GroundStudio/Jade_U1/README.md

GroundStudio Jade U1
====================================
JadeU1

Get it from [ardushop.ro](https://ardushop.ro/ro/118-groundstudio)

Explore all the GroundStudio products at [GroundStudio.ro](https://groundstudio.ro/)

Description
-------------------
ATMEGA328P based development board, 32kBytes of In-System Self-Programmable Flash program memory,  1kBytes EEPROM, 2kBytes Internal SRAM, 6 PWM Pins, 20 Digital Pins including 6 ADC with 10 bit Resolution and HT42B534-2 chip for USB comunication.

Contents
-------------------

* [/Documentation](https://github.com/GroundStudio/Jade_U1/tree/main/Documentation) -- Pinout.
* [/Hardware](https://github.com/GroundStudio/Jade_U1/tree/main/Hardware) -- Schematics, layout.

Versions
-------------------
*(Not all tags shown)*

* [REV1.0.0]

License
-------------------

This is released under the [Attribution-ShareAlike 4.0 International (CC BY-SA 4.0)](https://creativecommons.org/licenses/by-sa/4.0/) license.
**You are welcome to use this for commercial purposes.**

Please consider contributing back to this project or others to help the open-source hardware community continue to thrive and grow! 

Certifications:

[Open Source Hardware Association](https://certification.oshwa.org/ro000026.html)   
   
certification-mark-RO000026-wide (https://certification.oshwa.org/ro000026.html)
