GroundStudio/Jade_U1/Documentation/REV1.0.0/REV1.0.0 RZUJBN_GS JADE U1 Pinout.pdf

## ISP Port

# GroundStudio Jade U1

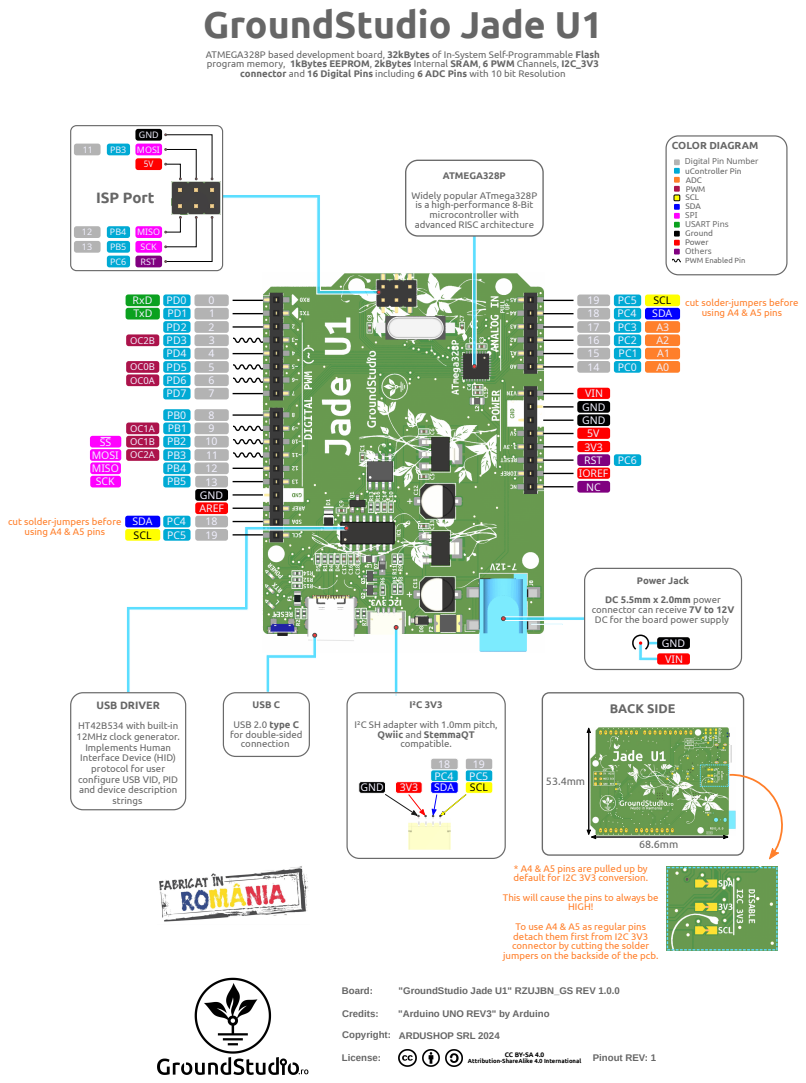
[picture p1: page 1]
Board:; Credits:; "Arduino UNO REV3" by Arduino; Copyright:; License:; ARDUSHOP SRL 2024; Pinout REV: 1; SDA; SCL; GND MOSI 5V; PB5 SCK; MISO; RST; TxD; RxD; AREF; GND; VIN; RST PC6; IOREF; USB DRIVER; strings; I²C 3V3; GND 3V3; SDA SCL; BACK SIDE; MOSI MISO; SCK; HIGH!; cut solder-jumpers before using A4 & A5 pins

ATMEGA328P based development board, 32kBytes of In-System Self-Programmable Flash
program memory, 1kBytes EEPROM, 2kBytes Internal SRAM, 6 PWM Channels, I2C_3V3

connector and 16 Digital Pins including 6 ADC Pins with 10 bit Resolution

COLOR DIAGRAM
Digital Pin Number
uController Pin
ADC
PWM
SCL
SDA
SPI
USART Pins
Ground
Power
Others
PWM Enabled Pin

ATMEGA328P
Widely popular ATmega328P
is a high-performance 8-Bit
microcontroller with
advanced RISC architecture

cut solder-jumpers before
using A4 & A5 pins

Power Jack
DC 5.5mm x 2.0mm power
connector can receive 7V to 12V
DC for the board power supply

USB C
USB 2.0 type C
for double-sided
connection

HT42B534 with built-in
12MHz clock generator.
Implements Human
Interface Device (HID)
protocol for user
configure USB VID, PID
and device description

I²C SH adapter with 1.0mm pitch,
Qwiic and StemmaQT
compatible.
SDA SCL

* A4 & A5 pins are pulled up by
default for I2C 3V3 conversion.
This will cause the pins to always be

To use A4 & A5 as regular pins
detach them first from I2C 3V3
connector by cutting the solder
jumpers on the backside of the pcb.

"GroundStudio Jade U1" RZUJBN_GS REV 1.0.0

Attribution-ShareAlike 4.0 International
