GroundStudio/Jade_U1/Documentation/REV1.0.0/REV1.0.0 RZUJBN_GS JADE U1 Schematic.pdf

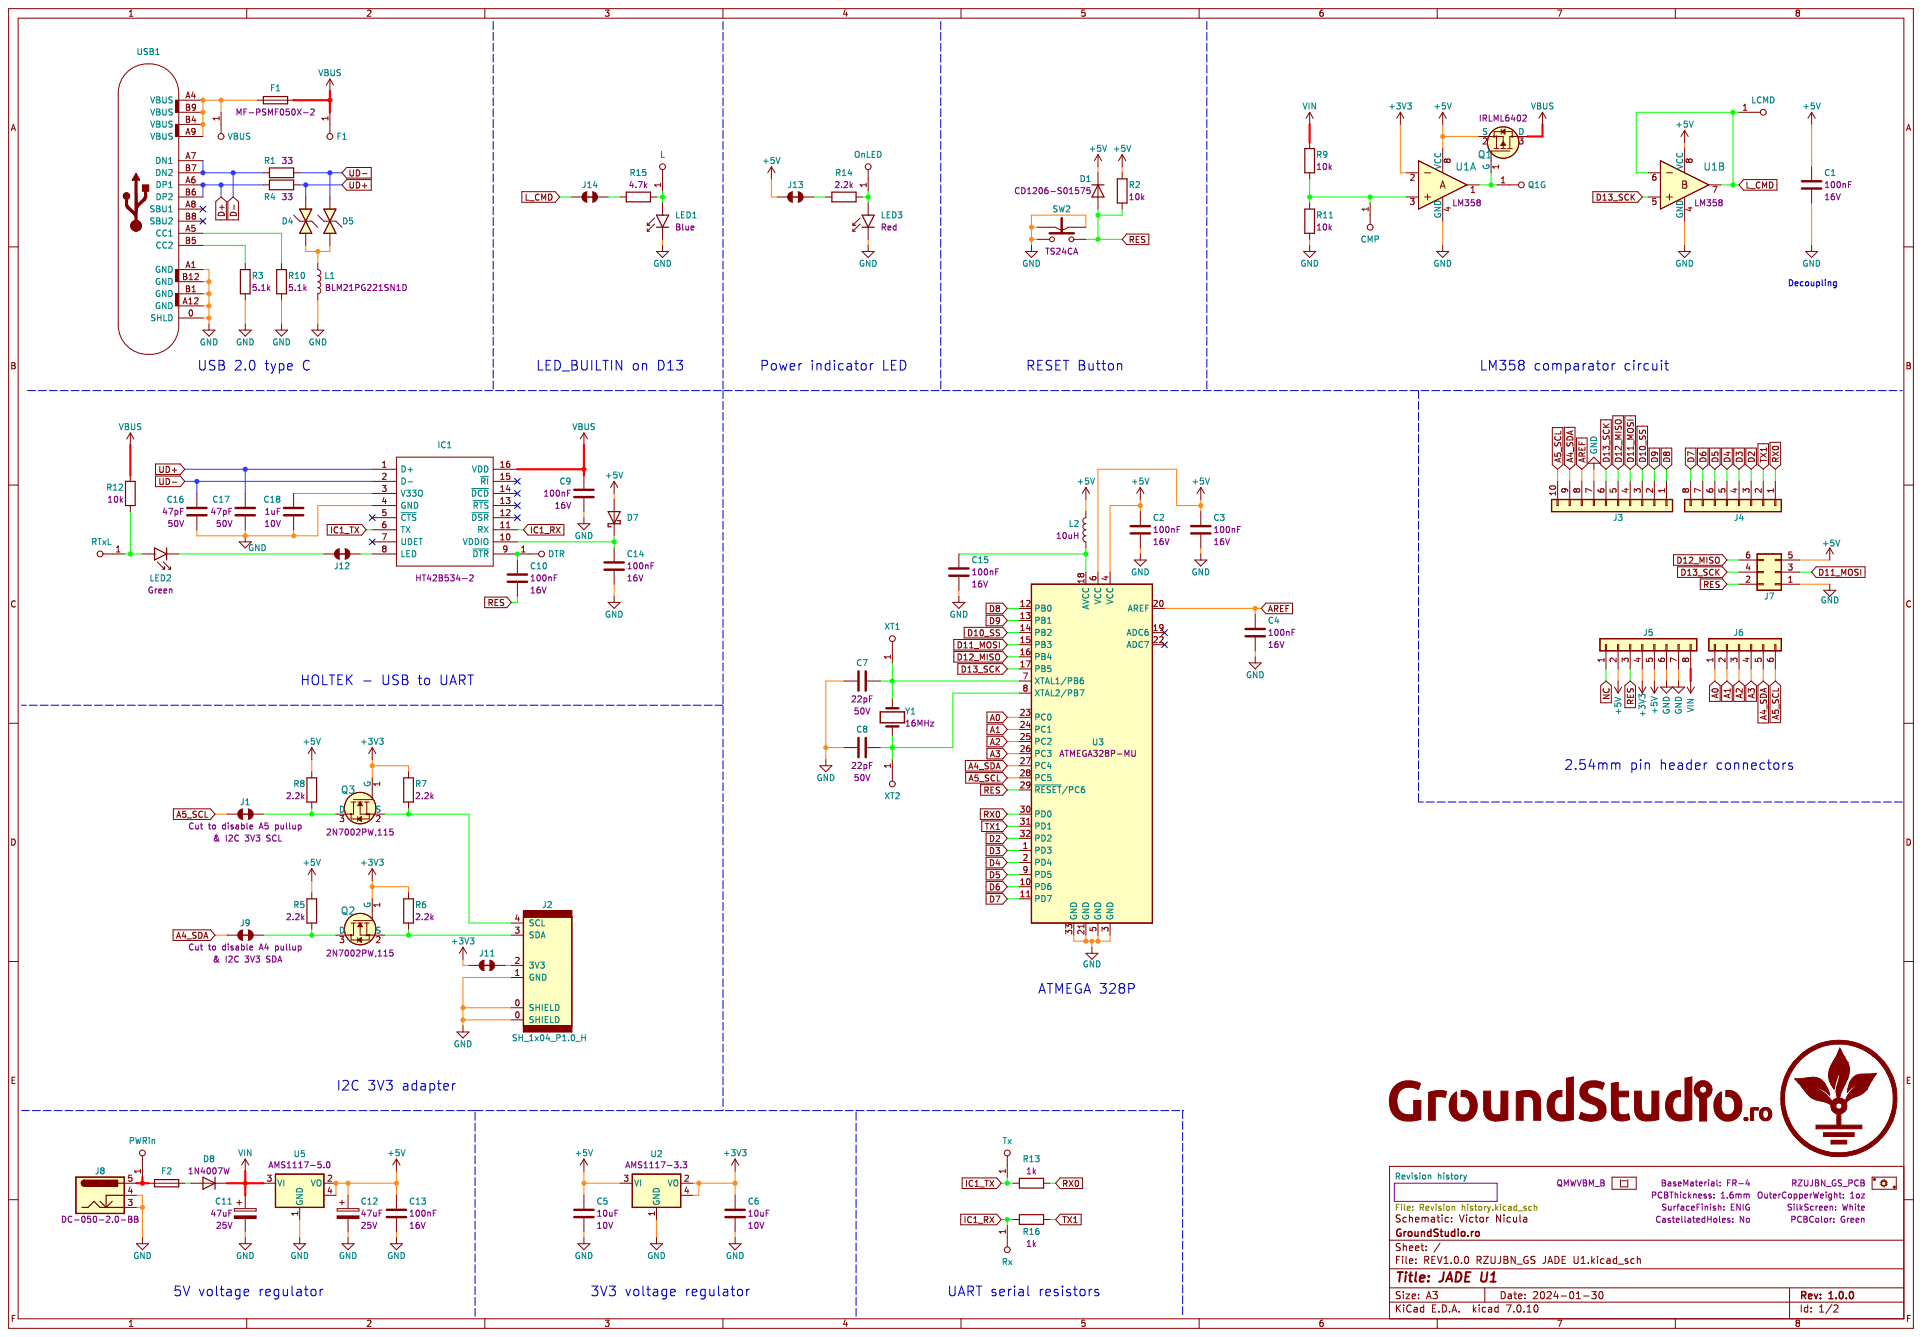
[picture p2: page 1]

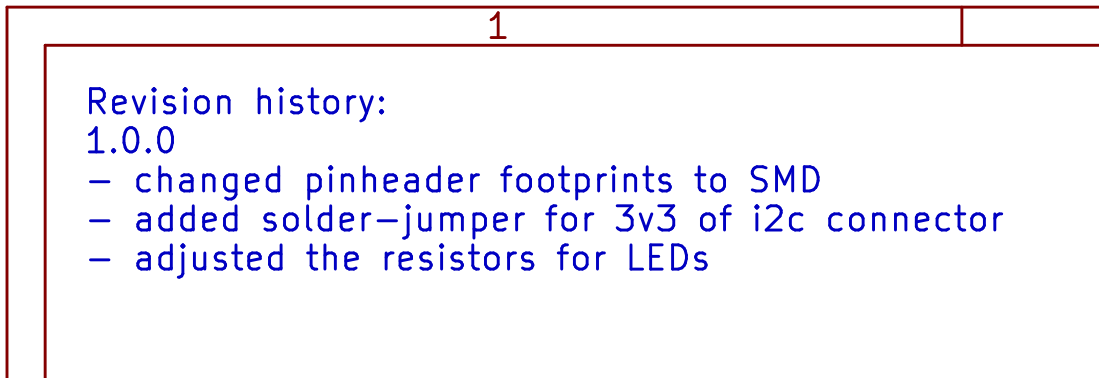
[picture p3: page 2]
