GroundStudio/Jade_U1/Hardware/REV1.0.0 - Kicad7/REV1.0.0 RZUJBN_GS JADE U1.kicad_sch

## KiCad design Hardware/REV1.0.0 - Kicad7/REV1.0.0 RZUJBN_GS JADE U1.kicad_sch (2024-02-02)

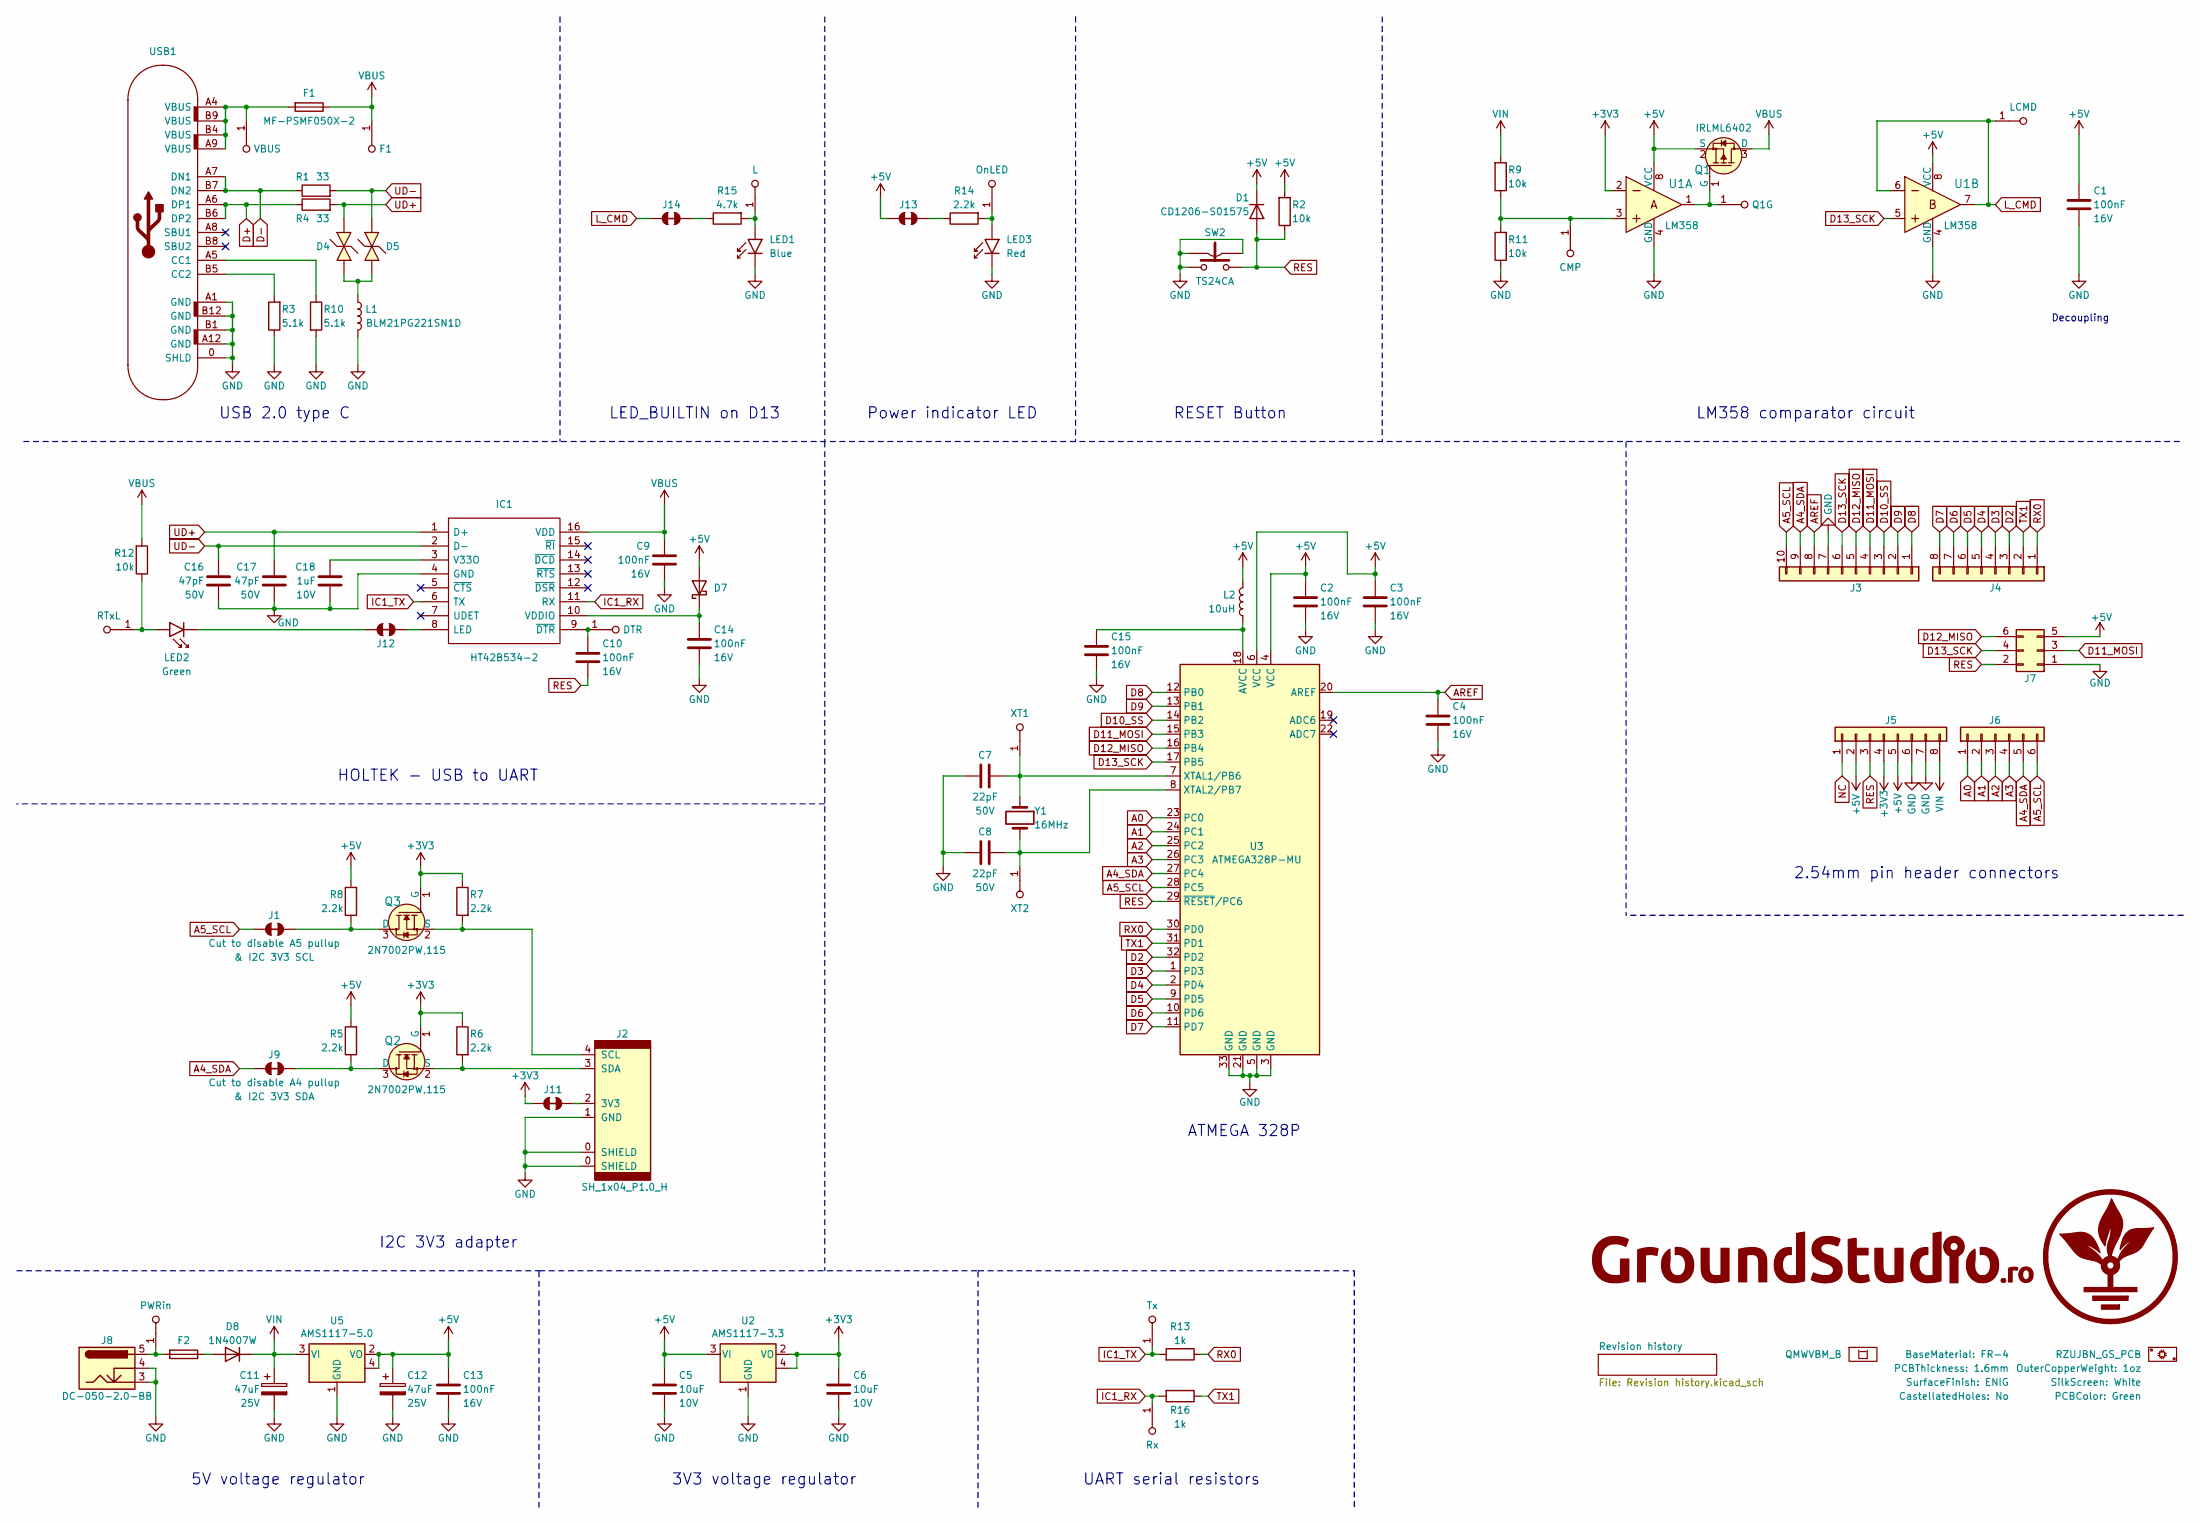
[picture p4: schematic REV1.0.0 RZUJBN_GS JADE U1.kicad_sch]

Parts:
B1: Bag_120x80mm_ZIP; MPN QMWVBM_B
C1, C2, C3, C4, C9, C10, C13, C14, C15: C_0402_100nF_16V; C_0402; MPN 0402B104K160CT; LCSC C83056
C5, C6: C_0402_10uF_10V; C_0402; Rated voltage 10V; MPN LDK105CBJ106MVLF; LCSC C386033
C7, C8: C_0402_22pF_50V; C_0402; Rated voltage 50V; MPN TCC0402C0G220J500AT; LCSC C466226
C11, C12: CP_Elec_6.3x5.4_47uF_25V; CP_Elec_6.3x5.4; Rated voltage 25V; MPN CS1E470M-CRE54; LCSC C97807
C16, C17: C_0402_47pF_50V; C_0402; MPN FN15N470J500PNG; LCSC C525215
C18: C_0402_1uF_10V; C_0402; MPN FS15B105K100PKG; LCSC C525324
D1: D_1206_CD1206-S01575; D_1206; MPN CD1206-S01575; LCSC C75465
D4, D5: ESD_0402_PS0402V014AT; ESD_0402; MPN PS0402V014AT; LCSC C125914
D7: SOD-323 SD103AWS; SOD-323; MPN SD103AWS; LCSC C438010
D8: SOD-123 1N4007W; SOD-123; MPN 1N4007W; LCSC C108803
F1: Fuse_0805_MF-PSMF050X-2; R_0805; MPN MF-PSMF050X-2; LCSC C116170
F2: Fuse_1812_MF-MSMF050-2; Fuse_1812; MPN MF-MSMF050-2; LCSC C17313
IC1: SOP-16_150MIL HT42B534-2; SOP-16_150MIL; Manufacturer_Part_Number HT42B534; LCSC C493361
J1, J9, J11: SolderJumper_NC; SolderJumper_NC_0.65-A_1Oz_OuterLayer_5C-T
J2: SH_1x04_P1.0_H; SH__1x04_P1.00mm_Horizontal; MPN C145956; LCSC C145956
J3: PinHeader_1x10_P2.54_V_F_SMD; PinH_1x10_P2.54_V_F_SMD+THT; MPN PinHeader_1x10_P2.54_V_F_SMD_R
J4, J5: PinHeader_1x8_P2.54_V_F_SMD; PinH_1x8_P2.54_V_F_SMD+THT; MPN PinHeader_1x8_P2.54_V_F_SMD_R
J6: PinH_1x6_P2.54_V_F_SMD; PinHeader_1x6_P2.54_V_F_SMD+THT; MPN PinHeader_1x6_P2.54_V_F_SMD_R
J7: PinHeader_2x03_P2.54_V_M_SMD; PinS_2x03_P2.54_V_F_SMD+THT; MPN C192301; LCSC C192301
J8: DC-005-5.5-Barr_Jck_SMD; DC-005-5.5-2.0MM-SMD; MPN DC-050-2.0-BB; LCSC C521456
J12, J13, J14: SolderJumper_NC
L1: L_0805_BLM21PG221SN1D; L_0805; MPN BLM21PG221SN1D; LCSC C85840
L2: L_0805_SCMI201209X100KT; L_0805; MPN SCMI201209X100KT; LCSC C479906
LED1: LED_0402_BLUE; LED_0402_alt; MPN TZ-P2-0402BTIA1-0.45T; LCSC NA
LED2: LED_0402_GREEN; LED_0402_alt; MPN TZ-P2-0402GTIA1-0.45T; LCSC C688877
LED3: LED_0402_RED; LED_0402_alt; MPN TZ-P2-0402RTIA1-0.45T; LCSC C779449
PCB1: PCB; MPN RZUJBN_GS_PCB
Q1: SOT-23 IRLML6402; SOT-23-3; MPN IRLML6402; LCSC C518785
Q2, Q3: SOT-323 2N7002PW; SOT-323_SC-70; MPN 2N7002PW,115; LCSC C255579
R1, R4: R_0402_33; R_0402; MPN RC-02W33R0FT; LCSC C140161
R2, R9, R11, R12: R_0402_10k; R_0402; MPN 0402WGJ0103TCE; LCSC C25531
R3, R10: R_0402_5.1k; R_0402; MPN RC-02W5101FT; LCSC C294638
R5, R6, R7, R8, R14: R_0402_2.2k; R_0402; MPN RC-02W2201FT; LCSC C258093
R13, R16: R_0402_1k; R_0402; MPN RC-02W1001FT; LCSC C226166
R15: R_0402_4.7k; R_0402; MPN WR04X4701FTL; LCSC C163826
SW2: TS24CA; MPN TS24CA; LCSC C393942
TP1: VBUS; TestPoint
TP2: F1; TestPoint
TP3: LCMD; TestPoint
TP5: Q1G; TestPoint
TP6: CMP; TestPoint
TP7: Tx; TestPoint
TP8: L; TestPoint
TP9: Rx; TestPoint
TP10: OnLED; TestPoint
TP13: RTxL; TestPoint
TP16: XT1; TestPoint
TP18: XT2; TestPoint
TP19: DTR; TestPoint
TP23: PWRin; TestPoint
U1: SOP-8_3.9x4.9_P1.27 LM358; SOP-8_3.9x4.9mm_P1.27mm; MPN LM358; LCSC C329455
U2: SOT-223 AMS1117-3.3; SOT-223; MPN AMS1117-3.3; LCSC C347222
U3: QFN-32_5x5_P0.5_328P-MU; QFN-32-1EP_5x5_P0.5_EP3.1x3.1; MPN ATMEGA328P-MU; LCSC C38896
U5: SOT-223 AMS1117-5.0; SOT-223; MPN AMS1117-5.0; LCSC C473812
USB1: USB_C_FULL; USB_C_C167321; MPN 918-418K2023S40001; LCSC C167321
Y1: HC49-SMD 5M0-1600A2020; Crystal_HC49-SMD; MPN 5M0-1600A2020-01; LCSC C389693

Connections:
+3V3: C6.1, J5.4, J11.1, Q2.1 (G), Q3.1 (G), R6.1, R7.1, U1.2, U2.2 (VO), U2.4
+5V: C1.1, C2.1, C3.1, C5.1, C12.1, C13.1, D1.1 (K), D7.2 (A), J5.2, J5.5, J7.5, J13.1, L2.1, Q1.2 (S), R2.2, R5.2, R8.2, U1.8 (VCC), U2.3 (VI), U3.4 (VCC), U3.6 (VCC), U5.2 (VO), U5.4
A0: J6.1, U3.23 (PC0)
A1: J6.2, U3.24 (PC1)
A2: J6.3, U3.25 (PC2)
A3: J6.4, U3.26 (PC3)
A4_SDA: J3.9, J6.5, J9.2, U3.27 (PC4)
A5_SCL: J1.2, J3.10, J6.6, U3.28 (PC5)
AREF: C4.1, J3.8, U3.20 (AREF)
D2: J4.3, U3.32 (PD2)
D3: J4.4, U3.1 (PD3)
D4: J4.5, U3.2 (PD4)
D5: J4.6, U3.9 (PD5)
D6: J4.7, U3.10 (PD6)
D7: J4.8, U3.11 (PD7)
D8: J3.1, U3.12 (PB0)
D9: J3.2, U3.13 (PB1)
D10_SS: J3.3, U3.14 (PB2)
D11_MOSI: J3.4, J7.3, U3.15 (PB3)
D12_MISO: J3.5, J7.6, U3.16 (PB4)
D13_SCK: J3.6, J7.4, U1.5, U3.17 (PB5)
D+: R4.1, USB1.A6 (DP1), USB1.B6 (DP2)
D-: R1.1, USB1.A7 (DN1), USB1.B7 (DN2)
GND: C1.2, C2.2, C3.2, C4.2, C5.2, C6.2, C7.1, C8.1, C9.2, C11.2, C12.2, C13.2, C14.2, C15.2, C16.1, C17.1, C18.2, IC1.4 (GND), J2.0 (SHIELD), J2.1 (GND), J3.7, J5.6, J5.7, J7.1, J8.3, J8.4, L1.2, LED1.1 (K), LED3.1 (K), R3.1, R10.2, R11.1, SW2.1, SW2.2, SW2.3, U1.4 (GND), U2.1 (GND), U3.3 (GND), U3.5 (GND), U3.21 (GND), U3.33 (GND), U5.1 (GND), USB1.0 (SHLD), USB1.A1 (GND), USB1.A12 (GND), USB1.B1 (GND), USB1.B12 (GND)
IC1_RX: IC1.11 (RX), R16.2, TP9.1
IC1_TX: IC1.6 (TX), R13.2, TP7.1
L_CMD: J14.1, TP3.1, U1.6, U1.7
NC: J5.1
unnamed: C7.2, TP16.1, U3.7 (XTAL1/PB6), Y1.1
unnamed: C8.2, TP18.1, U3.8 (XTAL2/PB7), Y1.2
unnamed: C10.1, IC1.9 (~DTR), TP19.1
unnamed: C14.1, D7.1 (K), IC1.10 (VDDIO)
unnamed: C15.1, L2.2, U3.18 (AVCC)
unnamed: C18.1, IC1.3 (V33O)
unnamed: D4.1, D5.2, L1.1
unnamed: D8.2 (A), F2.1
unnamed: F1.2, TP1.1, USB1.A4 (VBUS), USB1.A9 (VBUS), USB1.B4 (VBUS), USB1.B9 (VBUS)
unnamed: F2.2, J8.5, TP23.1
unnamed: IC1.8 (LED), J12.1
unnamed: J1.1, Q3.3 (D), R8.1
unnamed: J2.3 (SDA), Q2.2 (S), R6.2
unnamed: J2.4 (SCL), Q3.2 (S), R7.2
unnamed: J9.1, Q2.3 (D), R5.1
unnamed: J2.2 (3V3), J11.2
unnamed: J12.2, LED2.1 (K)
unnamed: J13.2, R14.1
unnamed: J14.2, R15.1
unnamed: LED1.2 (A), R15.2, TP8.1
unnamed: LED2.2 (A), R12.1, TP13.1
unnamed: LED3.2 (A), R14.2, TP10.1
unnamed: Q1.1 (G), TP5.1, U1.1
unnamed: R3.2, USB1.B5 (CC2)
unnamed: R10.1, USB1.A5 (CC1)
unnamed: R9.1, R11.2, TP6.1, U1.3
RES: C10.2, D1.2 (A), J5.3, J7.2, R2.1, SW2.4, U3.29 (~RESET/PC6)
RX0: J4.1, R13.1, U3.30 (PD0)
TX1: J4.2, R16.1, U3.31 (PD1)
UD+: C17.2, D4.2, IC1.1 (D+), R4.2
UD-: C16.2, D5.1, IC1.2 (D-), R1.2
VBUS: C9.1, F1.1, IC1.16 (VDD), Q1.3 (D), R12.2, TP2.1
VIN: C11.1, D8.1 (K), J5.8, R9.2, U5.3 (VI)

Notes on the sheet:
3V3 voltage regulator
LM358 comparator circuit
2.54mm pin header connectors
I2C 3V3 adapter
5V voltage regulator
LED_BUILTIN on D13
Power indicator LED
Decoupling
USB 2.0 type C
HOLTEK - USB to UART
UART serial resistors
RESET Button
ATMEGA 328P
